antonprafanto/antboy/(commit log)

2026-09-30 feat: initial release for ANTBOY (production gerbers & firmware)
    [pcb-B_Cu.gbr, pcb-B_Mask.gbr, pcb-B_Paste.gbr, pcb-B_Silkscreen.gbr, pcb-Edge_Cuts.gbr, pcb-F_Cu.gbr, pcb-F_Mask.gbr, pcb-F_Paste.gbr]
2026-09-30 fix(display): set orientation to landscape 320x240 facing buttons with adapted HUD
    [main.cpp]
2026-09-30 perf(audio): optimize buzzer tones to piezo resonance peak (1.7 - 3.1 kHz)
    [main.cpp]
2026-09-30 docs(prd): upgrade to PRD v1.1 with comprehensive pinout, SPI arbitration, HW errata, and BOM
2026-09-30 docs(prd): upgrade to PRD v1.2 Gold Master with SDK, Web Flasher, QC Test, SD specs, Battery guidelines, and Anti-Cloning strategy
2026-09-30 docs(prd): correct mounting holes to 5x M3 and update physical button layout from 3D render
2026-09-30 docs(todo): add custom partitions, DMA pipeline, shortcuts, and asset tools
2026-09-30 feat(sdk): implement AntBoy-Core SDK v1.0, custom 4MB partitions, and interactive dashboard
    [partitions.csv]
2026-09-30 feat(sdk): add hardware LEDC duty cycle volume control, debouncing, ADC filtering, and auto SD directory creation
2026-09-30 refactor(sdk): enhance combo hold reset, 5kHz LEDC backlight, SPI CS isolation, and RTC deep sleep wakeup
2026-09-30 feat(sdk): add thread-safe SD file I/O, brightness cycler, and anyPressed helper
2026-09-30 refactor(antos): add auto-dimming power saver, battery status icon, slide carousel animation, and fix OSD toast layering
2026-09-30 fix(games): implement in-game pause modal and allow dedicated MENU button to exit to launcher
2026-09-30 fix(display): boost SPI to 40MHz and implement dirty-rect rendering across AntOS launcher, menus, and games to eliminate flickering
2026-09-30 fix(emulators): integrate official full Peanut-GB engine, fix FatFS path basename bug, and wire CHIP-8 SD loader
2026-10-01 fix(display): patch ST7789 MADCTL to 0xC8 for 180-degree rotation fix on vertical PCB
