antonprafanto/antboy/(notices)

Notices in the files:
README.md:
License: MIT
